hoffmannjoern/bottlemail_pcb/README.md

bottlemail_pcb
==============

PCB layout and schematics for Bottl(e)mail
