hoffmannjoern/bottlemail_pcb/BOM_Merged.ods

Qty | Lieferant | Order Number | Parts
1 | Aliexpress | Such as rhyme new original CN3065 DFN8 lithium battery charge management / protection chip IC | U3
5 | DigiKey | MSS1P2U | D2, D3, D4, D5, D6
2 | Farnell | 1469750 | R20, R21
2 | Farnell | 1469773RL | R18, R19
1 | Farnell | 2395925 | IC1
2 tot | Lipoly.de | 0.5W Solar Panel 5,5V 55x70mm SeeedStudio POW112D2P o.Ä. | SOLAR
2 | Lipoly.de | 2.5 mm JST XH-Style Shrouded Male Connector: 2-Pin, Straight (4-Pack) Pololu 2717 | SOLAR, LIPO-BAT
2 | Reichelt | BL 1X10G SMD2,00 | XBEE_SOCKET
1 | Reichelt | 16,0000-HC49U-S | Q1
1 | Reichelt | ATMEGA 1284P-AU | ATMEGA1284P-AU
1 | Reichelt | FT 232 RL | UART1_IC2
1 | Reichelt | IRLML 6402 | T_LIPO_USB
1 | Reichelt | L-1812AS 22µ | UART1_L2
2 | Reichelt | LG L29K | LED2, UART1_TX_LED
2 | Reichelt | LS L29K | LED1, UART1_RX_LED
2 | Reichelt | NPO-G0603 22P | C1, C9
0.33 | Reichelt | SL 1X36G 2,54, geteilt mit J1 reicht für jeweils 3 Boards | I2C
0 |  | siehe I2C (Zeile oben drüber) | JP1
3 | Reichelt | SMD-0603 1,0K | R9, R14, R15
2 | Reichelt | SMD-0603 100K | R6, R8
14 | Reichelt | SMD-0603 10K | R1, R2, R3, R4, R5, R7, R10, R11, R12, R13, R16, R_RESET, R_WAKEUP, UART1_R6
3 | Reichelt | SMD-0603 2,2K | R17, UART1_R7, UART1_R10
4 | Reichelt | TASTER 3301 | RESET_SW, SW_BEE_RST, SW_CHARGE_INDICATORS, SW_WAKEUP
1 | Reichelt | WSL 6G | ISP1
4 | Reichelt | X5R-G0805 10/16 | C17, C18, C19, C20
13 | Reichelt | X7R-G0603 100N | C2, C3, C4, C6, C7, C8, C11, C12, C14, C15, C16, UART1_C2, UART1_C11
2 | Reichelt | X7R-G0603 10N | UART1_C1, UART1_C10
3 | Reichelt | X7R-G1210 1,0 | C5, C10, C13
3 | Reichelt | ZVN 3306 F | Q5, Q6, Q7
3 | Seed Studio | ACC39145O | GROOVE_A6_A7, GROOVE_D7_D8, GROOVE_I2C
1 | Seed Studio | BLE Bee - Based on HM-11 Module | U2
1 | Seed Studio | Bluetooth V4.0 HM-11 BLE Module
1 | Sparkfun | PRT-00127 | U1
1 | Sparkfun | PRT-11417 Part 1/4 | AD
1 | Sparkfun | PRT-11417 Part 1/4 | POWER
1 | Sparkfun | PRT-11417 Part 2/4 | IOH
1 | Sparkfun | PRT-11417 Part 3/4 | IOL
1 | Sparkfun | PRT-00587 | USB_CONNECTOR
2 tot | Sparkfun | PRT-00339 | LIPO_BAT
