hoffmannjoern/bottlemail_pcb/Bottle_PCB_Components.pdf

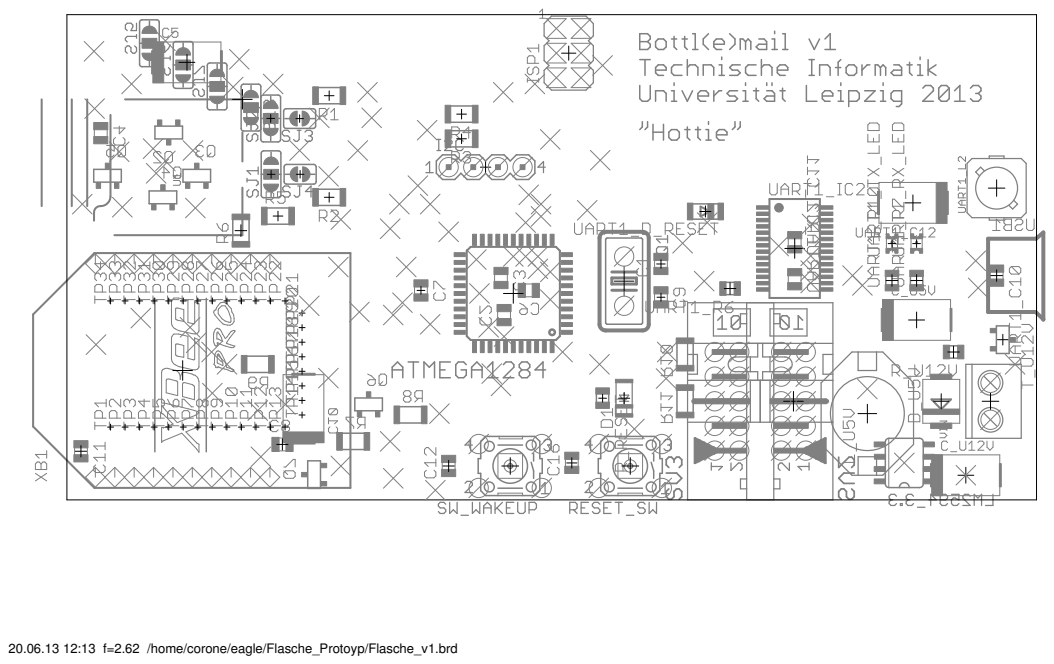
[picture p1: page 1]

20.06.13 12:13 f=2.62 /home/corone/eagle/Flasche_Protoyp/Flasche_v1.brd
