hoffmannjoern/bottlemail_pcb/Bottle_PCB_Board.pdf

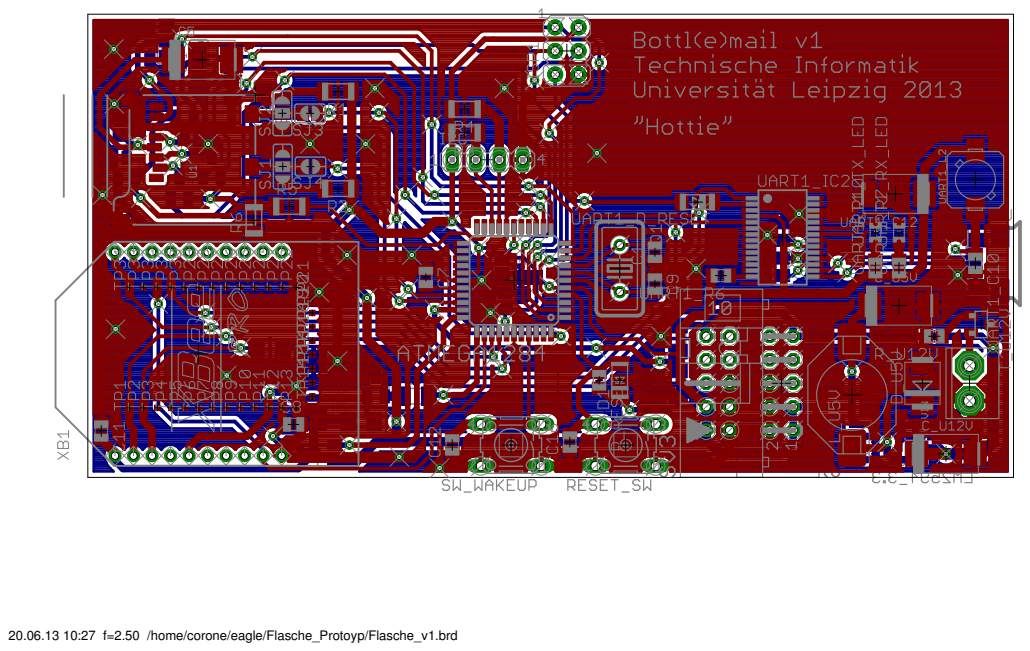
[picture p2: page 1]

20.06.13 10:27 f=2.50 /home/corone/eagle/Flasche_Protoyp/Flasche_v1.brd
