hoffmannjoern/bottlemail_pcb/Bottle_PCB_Board_Top.pdf

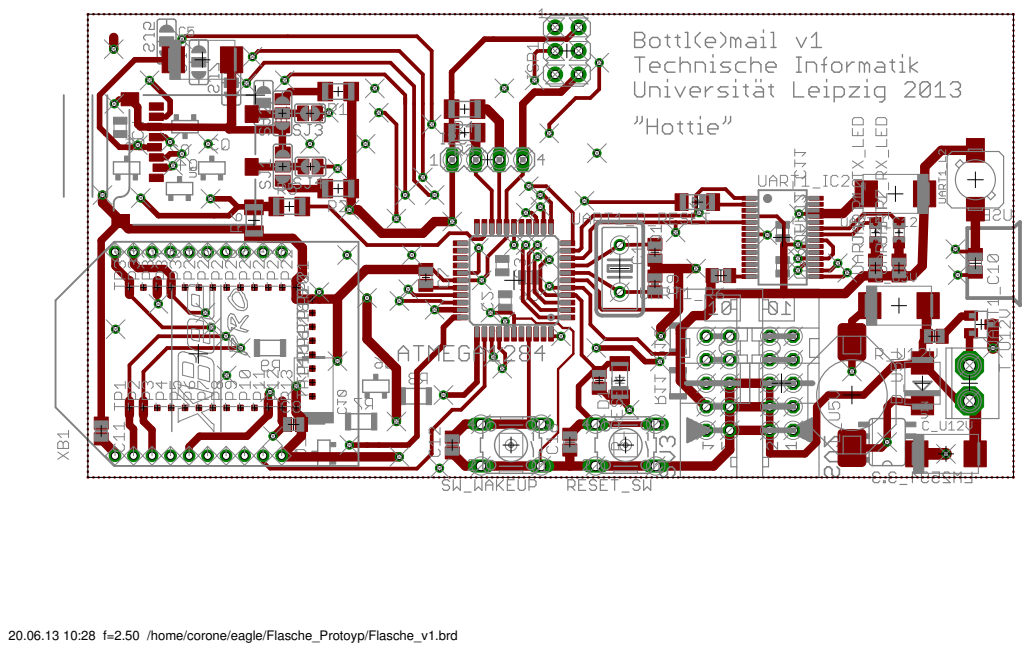
[picture p3: page 1]

20.06.13 10:28 f=2.50 /home/corone/eagle/Flasche_Protoyp/Flasche_v1.brd
