hoffmannjoern/bottlemail_pcb/Bottle_PCB_Layout.pdf

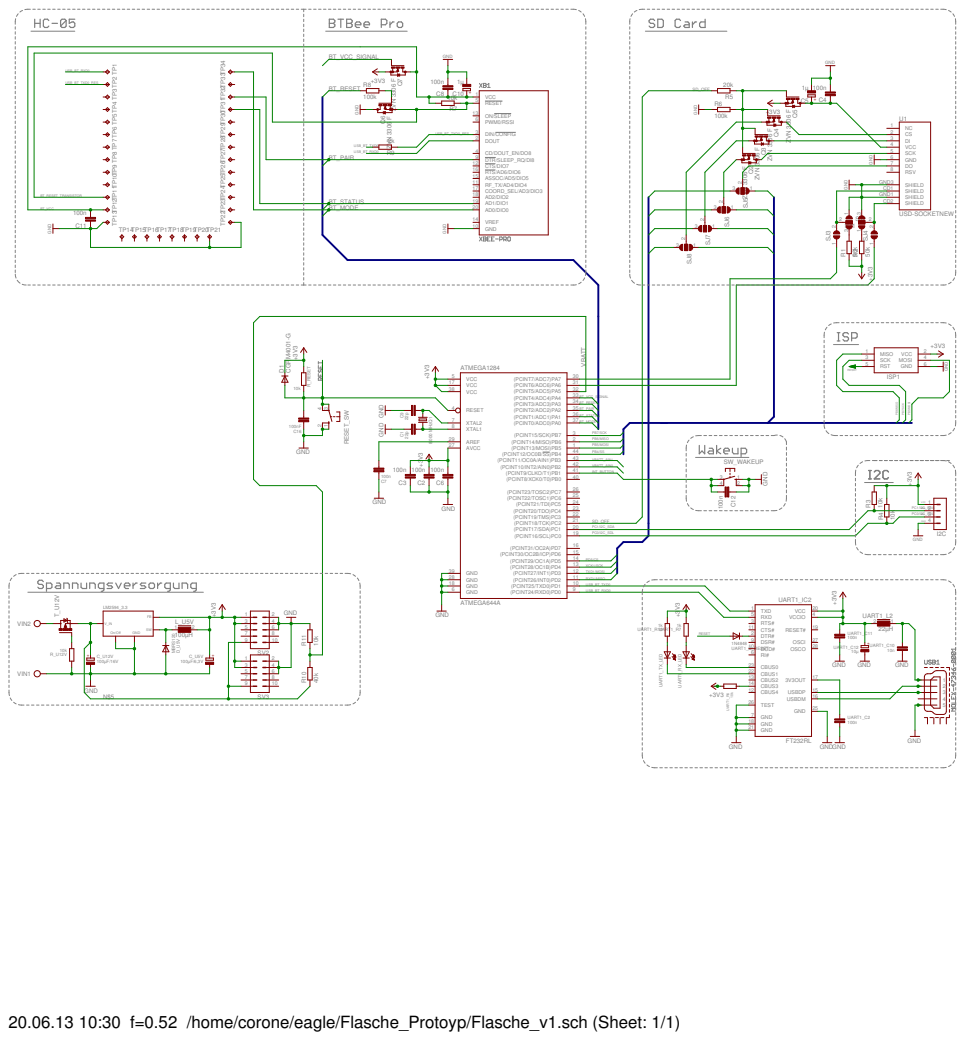
[picture p4: page 1]

BT_VCC_SIGNAL

20.06.13 10:30 f=0.52 /home/corone/eagle/Flasche_Protoyp/Flasche_v1.sch (Sheet: 1/1)
