hoffmannjoern/bottlemail_pcb/Bottle_PCB.brd

## EAGLE design Bottle_PCB.brd (2014-10-03)

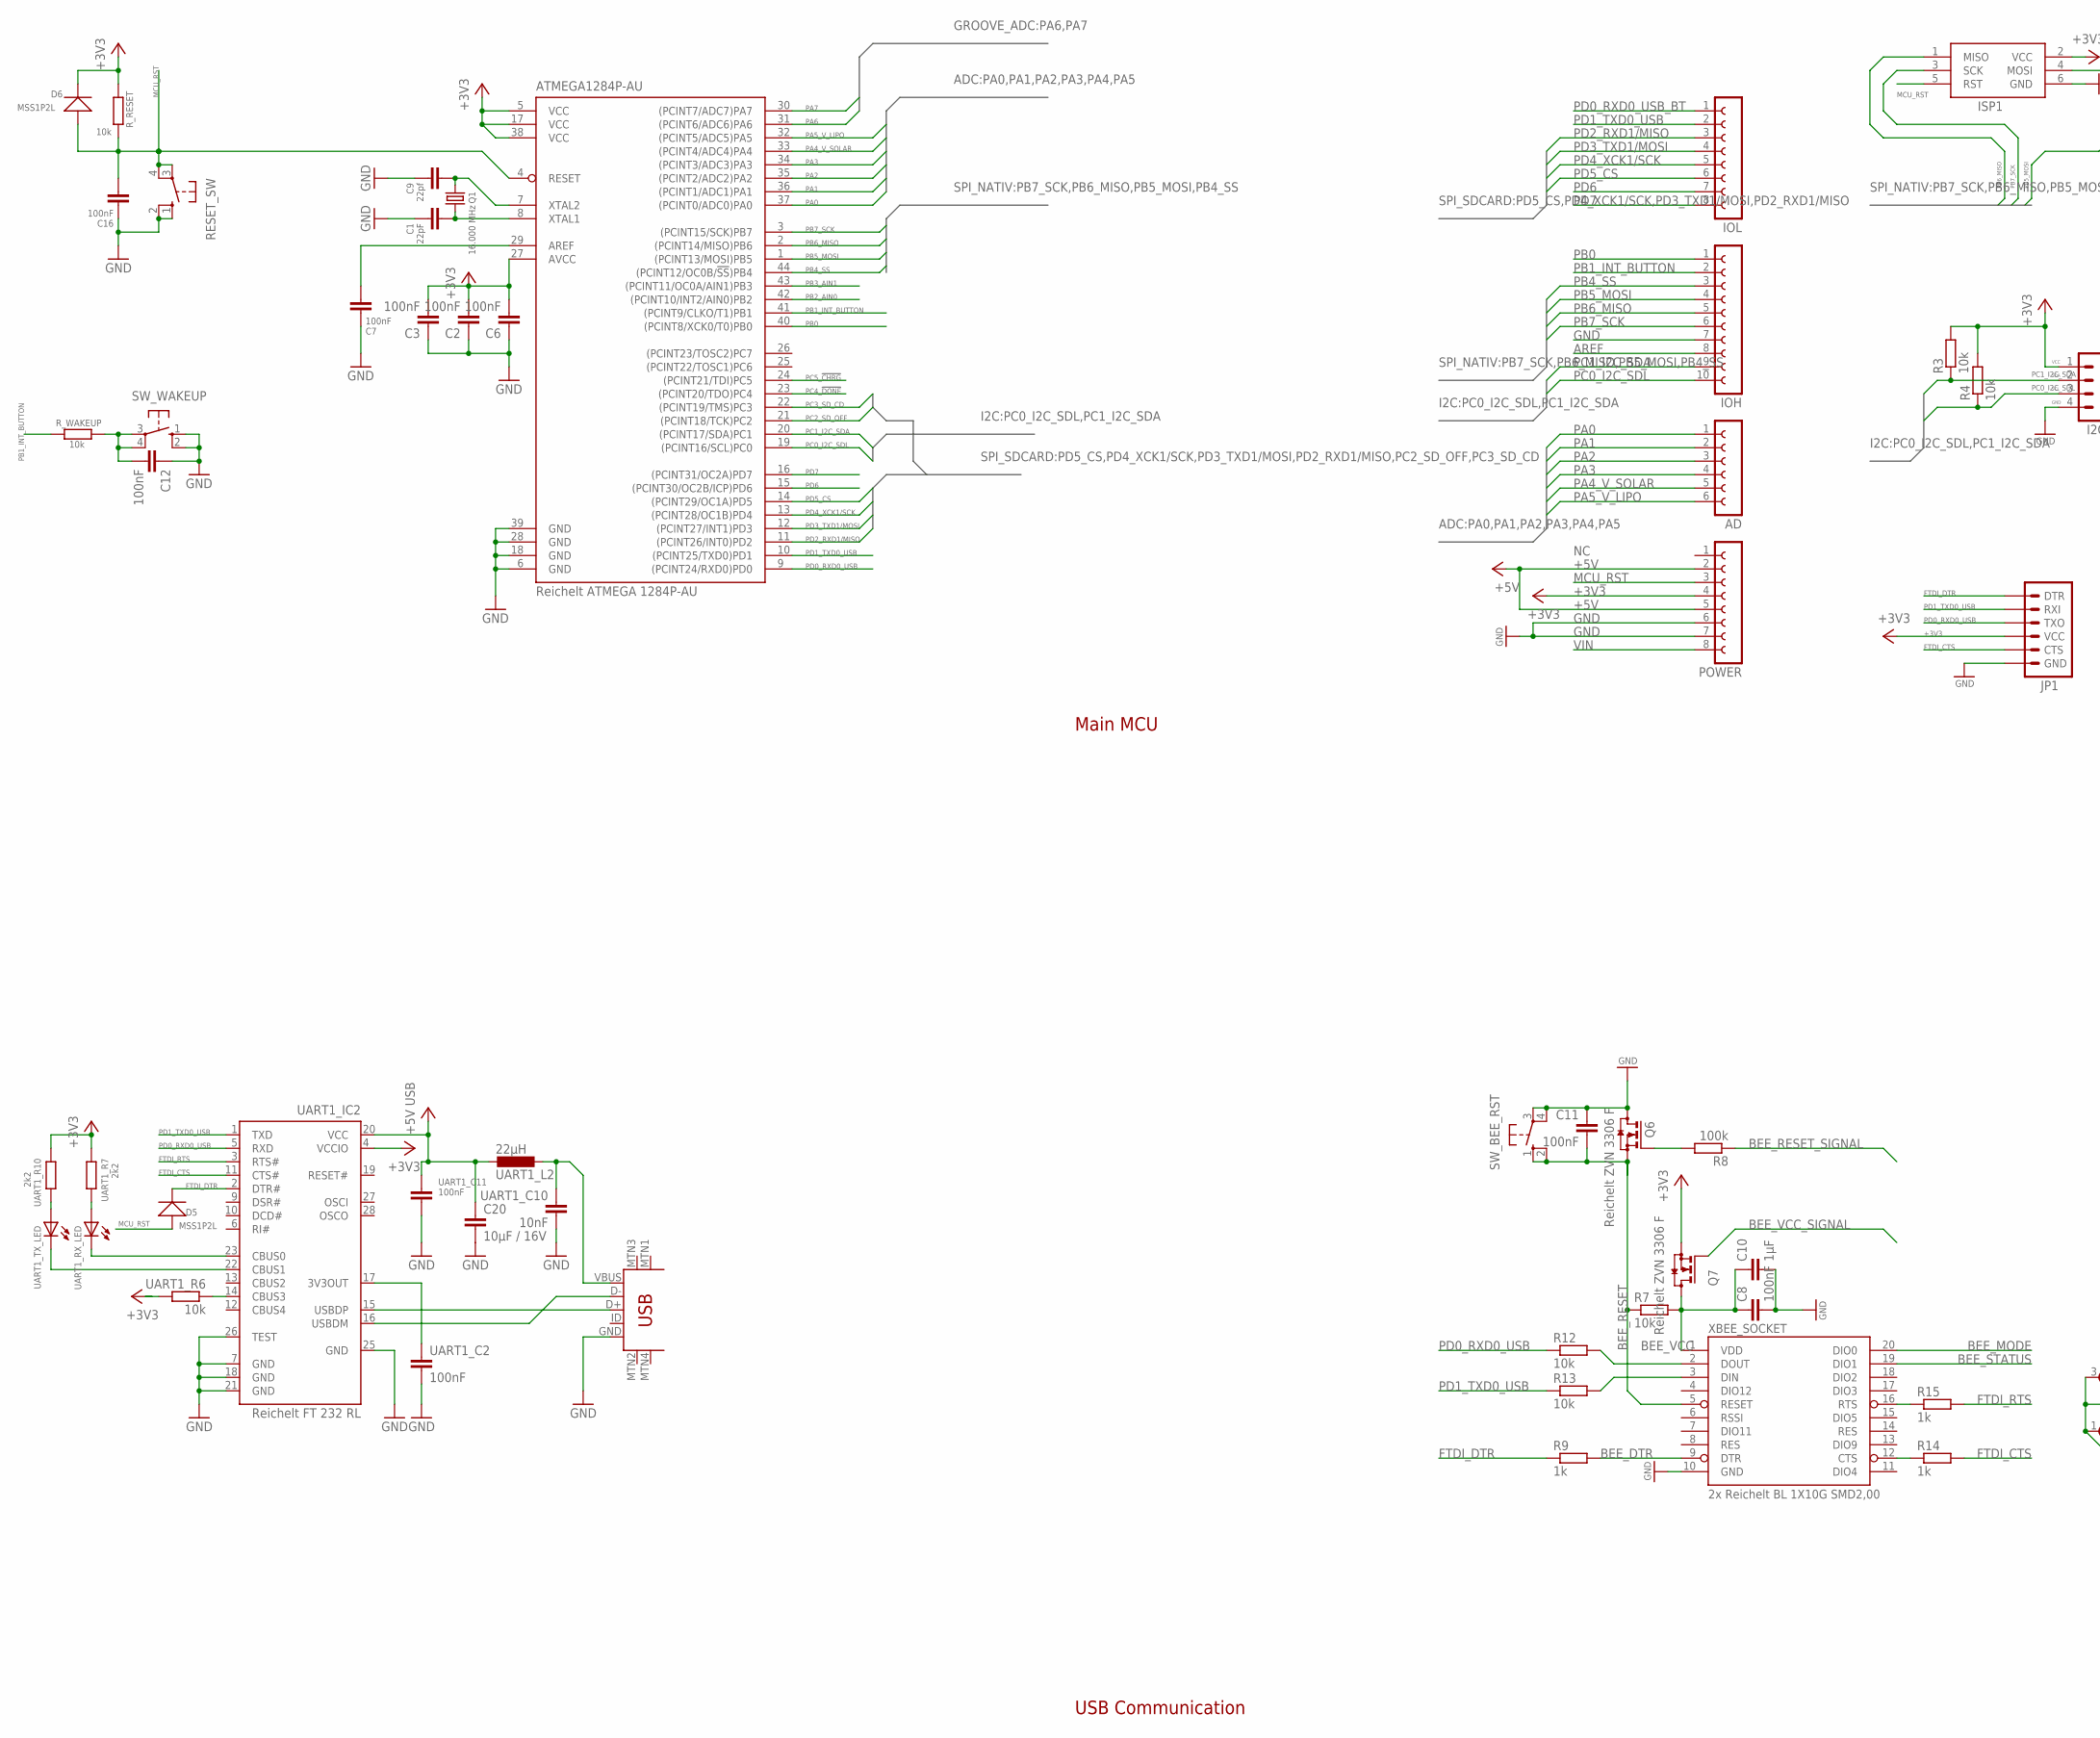
[picture p5: schematic Bottle_PCB.sch, Everything in order to support Eagle free Edition, part in row 1, column 1]

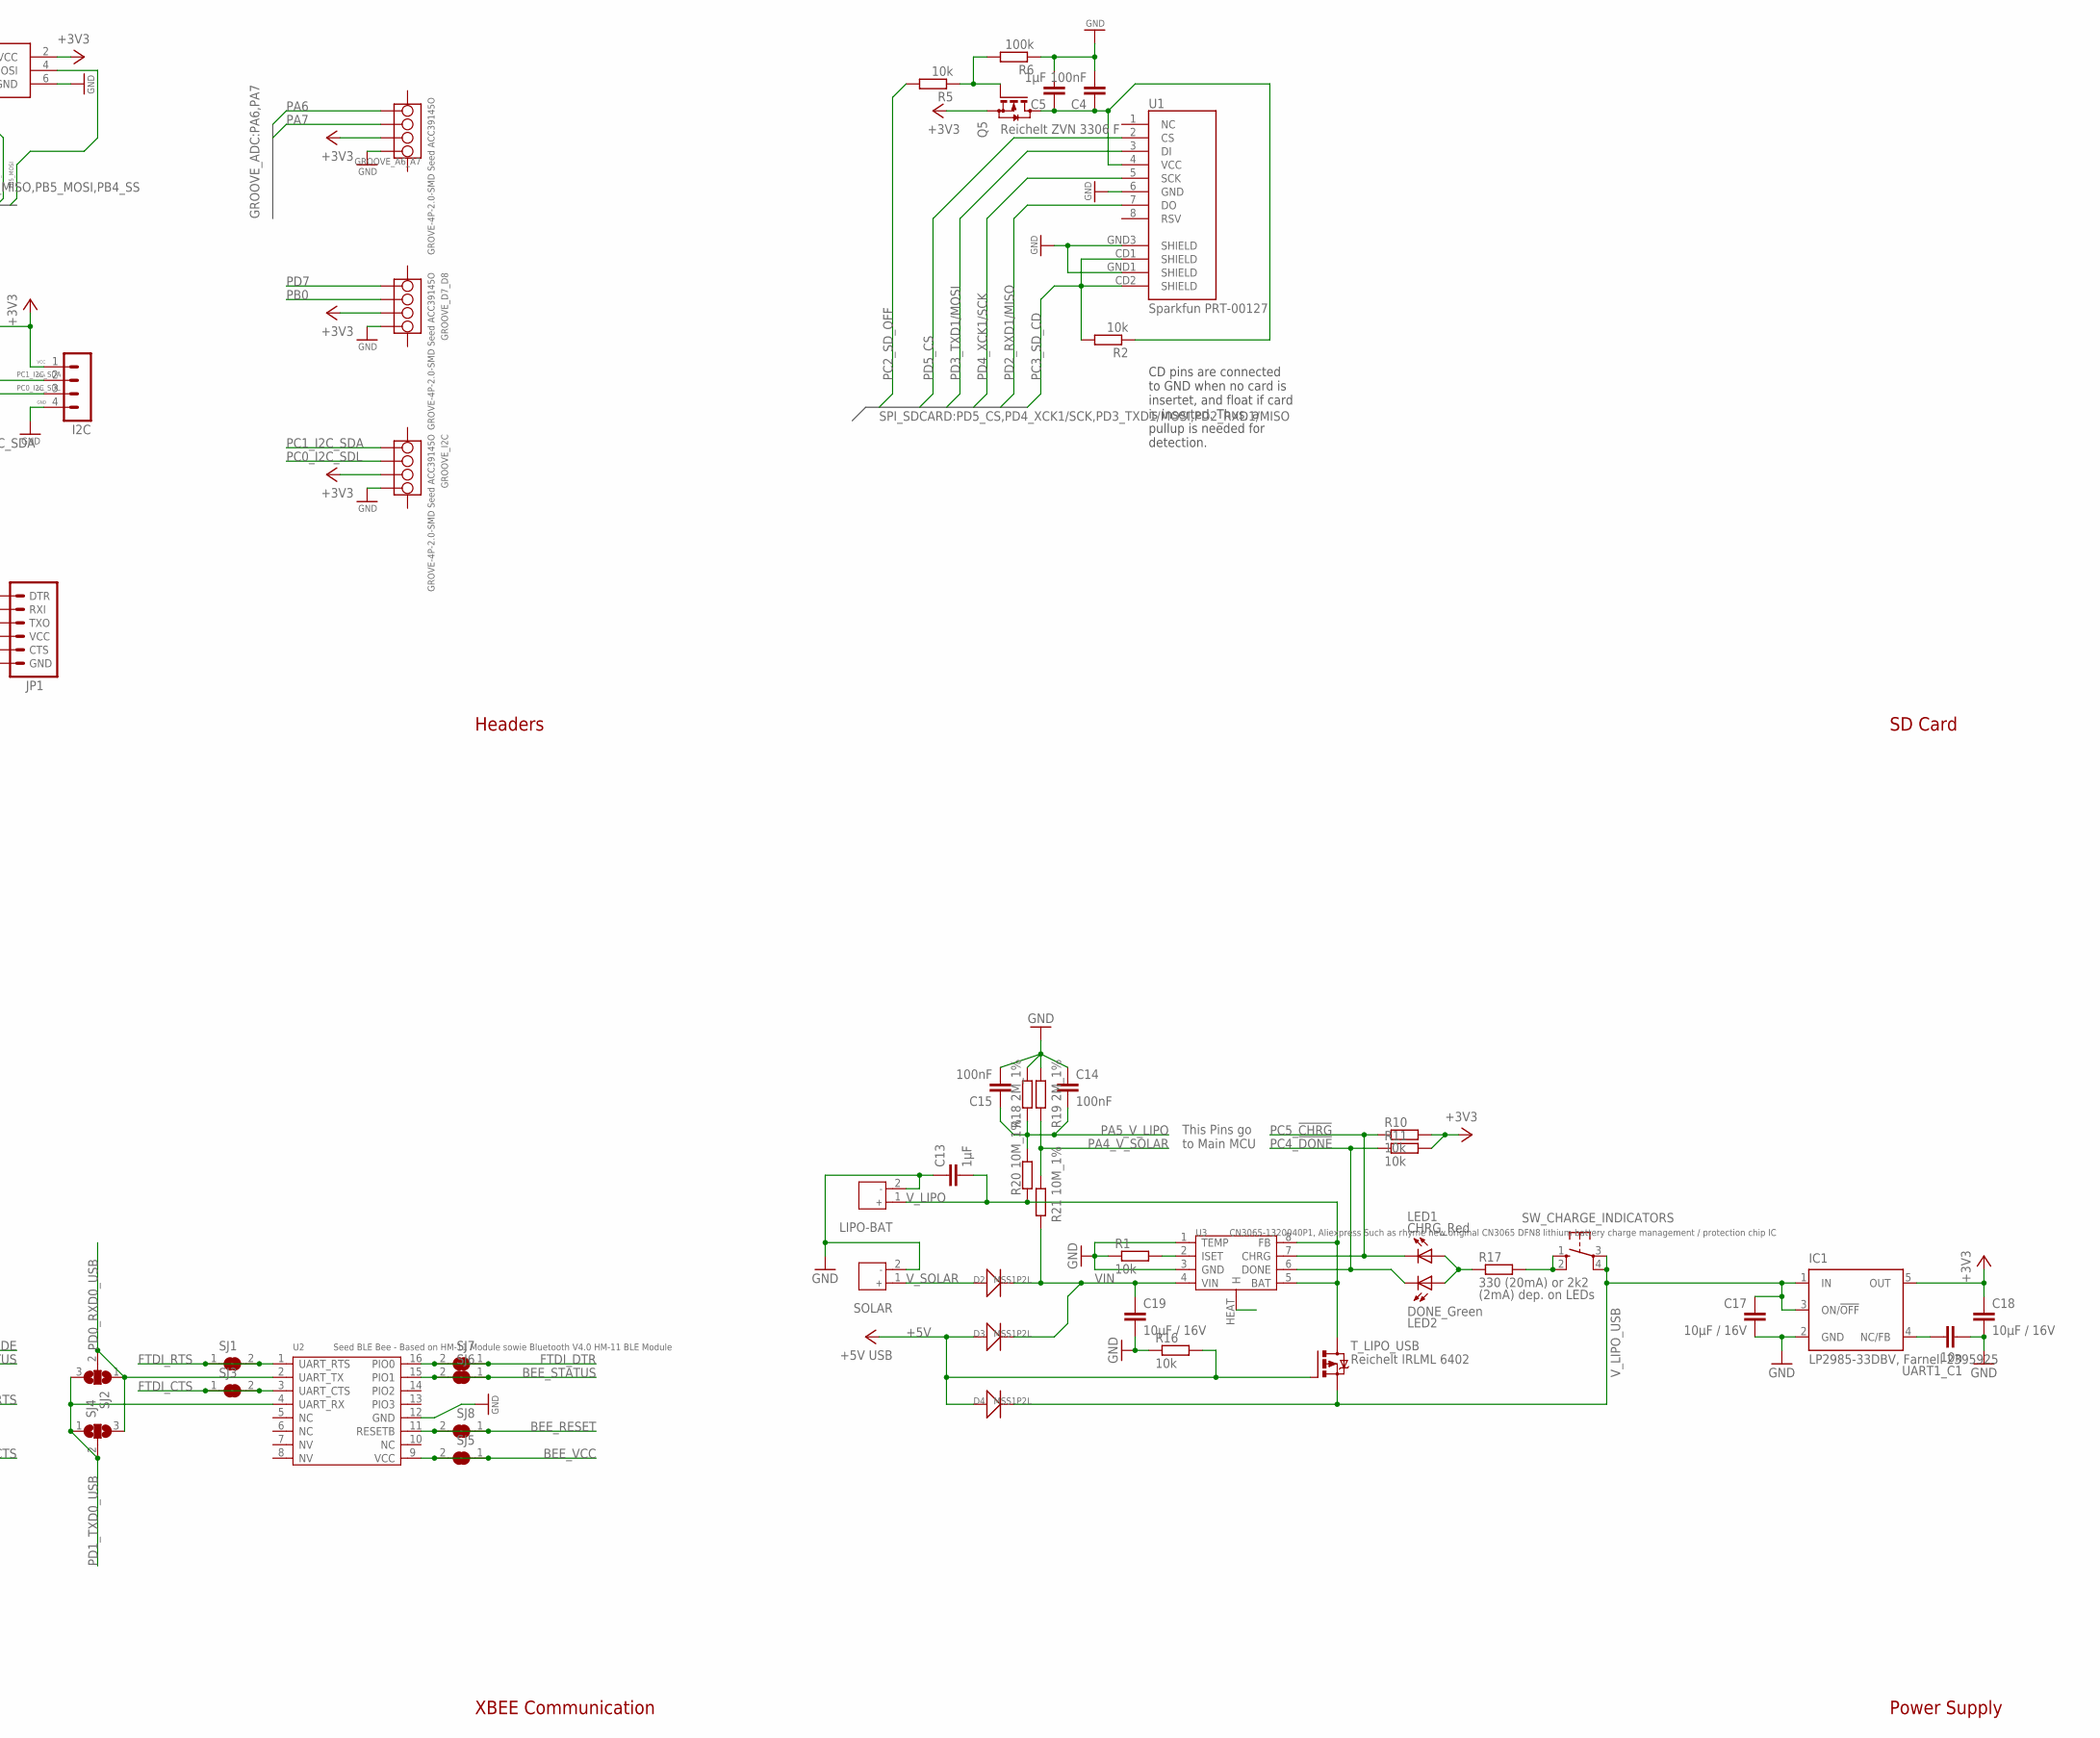
[picture p6: schematic Bottle_PCB.sch, Everything in order to support Eagle free Edition, part in row 1, column 2]

Parts:
AD: FE06-1; FE06
ATMEGA1284P-AU: Reichelt ATMEGA 1284P-AU; TQFP44
C1: 22pF; C0603-ROUND
C2, C3, C4, C6, C7, C8, C11, C12, C14, C15, C16: 100nF; C0603-ROUND
C5, C10, C13: 1µF; C1210
C9: 22pf; C0603-ROUND
C17, C18, C19, C20: 10µF / 16V; C0805
D2, D3, D4, D5, D6: MSS1P2L; D1005
GROOVE_A6_A7: GROVE-4P-2.0-SMD Seed ACC39145O; 4P-SMD-2.0
GROOVE_D7_D8: GROVE-4P-2.0-SMD Seed ACC39145O; 4P-SMD-2.0
GROOVE_I2C: GROVE-4P-2.0-SMD Seed ACC39145O; 4P-SMD-2.0
I2C: MA04-1
IC1: LP2985-33DBV, Farnell 2395925; SOT23-DBV
IOH: FE10-1; FE10
IOL: FE08-1; FE08
ISP1: Reichelt WSL 6G; AVRISP
JP1: ARDUINO_SERIAL_PROGRAMPTH; 1X06
LED1: CHRG_Red; CHIPLED_0603
LED2: DONE_Green; CHIPLED_0603
LIPO-BAT: JACK-JST-2P-PW2.0; JST-2.0
POWER: FE08-1; FE08
Q1: 16.000 MHz; HC49U-V
Q5, Q6, Q7: Reichelt ZVN 3306 F; SOT23
R1, R2, R3, R4, R5, R7, R10, R11, R12, R13, R16: 10k; R0603-ROUND
R6, R8: 100k; R0603-ROUND
R9, R14, R15: 1k; R0603-ROUND
R17: 330 (20mA) or 2k2; R0603-ROUND
R18, R19: 2M_1%; R0603-ROUND
R20, R21: 10M_1%; R0603-ROUND
RESET_SW: 10-XX; B3F-10XX
R_RESET: 10k; R0603-ROUND
R_WAKEUP: 10k; R0603-ROUND
SJ1, SJ3, SJ5, SJ6, SJ7, SJ8: SJ
SJ2, SJ4: SJ2W; SJ_2
SOLAR: JACK-JST-2P-PW2.0; JST-2.0
SW_BEE_RST: 10-XX; B3F-10XX
SW_CHARGE_INDICATORS: 10-XX; B3F-10XX
SW_WAKEUP: 10-XX; B3F-10XX
T_LIPO_USB: Reichelt IRLML 6402; SOT23
U1: Sparkfun PRT-00127; MICRO-SD-SOCKET-PP
U2: Seed BLE Bee - Based on HM-11 Module sowie Blueto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; 16P-18.5X13.5X0.8
U3: CN3065-1320040P1, Aliexpress Such as rhyme new or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; DFN8
UART1_C1: 10n; C0603-ROUND
UART1_C2, UART1_C11: 100nF; C0603-ROUND
UART1_C10: 10nF; C0603-ROUND
UART1_IC2: Reichelt FT 232 RL; SSOP28
UART1_L2: 22µH; L1812
UART1_R6: 10k; R0603-ROUND
UART1_R7, UART1_R10: 2k2; R0603-ROUND
UART1_RX_LED, UART1_TX_LED: LEDCHIPLED_0603; CHIPLED_0603
USB_CONNECTOR: USB-MINIB-5PIN Sparkfun PRT-00587; USB-MINIB
XBEE_SOCKET: 2x Reichelt BL 1X10G SMD2,00; XBEE-SMD

Connections:
+3V3: ATMEGA1284P-AU.5 (VCC), ATMEGA1284P-AU.17 (VCC), ATMEGA1284P-AU.27 (AVCC), ATMEGA1284P-AU.38 (VCC), C2.2, C3.2, C6.2, C18.1, D6.-, GROOVE_A6_A7.2, GROOVE_D7_D8.2, GROOVE_I2C.2, I2C.1, IC1.5 (OUT), ISP1.2 (VCC), JP1.VCC, POWER.4, Q5.2 (S), Q7.2 (S), R3.2, R4.2, R10.2, R11.2, R_RESET.2, UART1_IC2.4 (VCCIO), UART1_R6.2, UART1_R7.1, UART1_R10.1
+5V: C20.1, D3.+, D4.+, POWER.2, POWER.5, R16.2, T_LIPO_USB.1 (G), UART1_C11.1, UART1_IC2.20 (VCC), UART1_L2.2
AREF: ATMEGA1284P-AU.29 (AREF), C7.2, IOH.8
BEE_DTR: R9.2, XBEE_SOCKET.9 (DTR)
BEE_MODE: XBEE_SOCKET.20 (DIO0)
BEE_RESET: C11.2, Q6.2 (S), R7.1, SJ8.1, SJ8.2, SW_BEE_RST.1 (S), SW_BEE_RST.2 (S1), U2.11 (RESETB), XBEE_SOCKET.5 (RESET)
BEE_RESET_SIGNAL: R8.1
BEE_STATUS: SJ6.1, SJ6.2, U2.15 (PIO1), XBEE_SOCKET.19 (DIO1)
BEE_VCC: C8.1, C10.1, Q7.3 (D), R7.2, SJ5.1, SJ5.2, U2.9 (VCC), XBEE_SOCKET.1 (VDD)
BEE_VCC_SIGNAL: Q7.1 (G)
FTDI_CTS: JP1.CTS, R14.2, SJ3.1, SJ3.2, U2.3 (UART_CTS), UART1_IC2.11 (CTS#)
FTDI_DTR: D5.-, JP1.DTR, R9.1, SJ7.1, SJ7.2, U2.16 (PIO0), UART1_IC2.2 (DTR#)
FTDI_RTS: R15.2, SJ1.1, SJ1.2, U2.1 (UART_RTS), UART1_IC2.3 (RTS#)
GND: ATMEGA1284P-AU.6 (GND), ATMEGA1284P-AU.18 (GND), ATMEGA1284P-AU.28 (GND), ATMEGA1284P-AU.39 (GND), C1.1, C2.1, C3.1, C4.2, C5.2, C6.1, C7.1, C8.2, C9.1, C10.2, C11.1, C12.1, C13.1, C14.1, C15.2, C16.1, C17.2, C18.2, C19.2, C20.2, GROOVE_A6_A7.1, GROOVE_D7_D8.1, GROOVE_I2C.1, I2C.4, IC1.2 (GND), IOH.7, ISP1.6 (GND), JP1.GND, LIPO-BAT.2, POWER.6, POWER.7, Q6.3 (D), R1.1, R6.1, R16.1, R18.2, R19.2, RESET_SW.1 (S), RESET_SW.2 (S1), SOLAR.2, SW_BEE_RST.3, SW_BEE_RST.4 (P1), SW_WAKEUP.1 (S), SW_WAKEUP.2 (S1), U1.6 (GND), U1.GND1 (SHIELD), U1.GND3 (SHIELD), U2.12 (GND), U3.1 (TEMP), U3.3 (GND), UART1_C1.2, UART1_C2.2, UART1_C10.2, UART1_C11.2, UART1_IC2.7 (GND), UART1_IC2.18 (GND), UART1_IC2.21 (GND), UART1_IC2.25 (GND), UART1_IC2.26 (TEST), USB_CONNECTOR.GND, XBEE_SOCKET.10 (GND)
MCU_RST: ATMEGA1284P-AU.4 (RESET), C16.2, D5.+, D6.+, ISP1.5 (RST), POWER.3, RESET_SW.3, RESET_SW.4 (P1), R_RESET.1
unnamed: UART1_R10.2, UART1_TX_LED.A
unnamed: UART1_C2.1, UART1_IC2.17 (3V3OUT)
unnamed: IC1.4 (NC/FB), UART1_C1.1
unnamed: UART1_IC2.16 (USBDM), USB_CONNECTOR.D-
unnamed: R14.1, XBEE_SOCKET.12 (CTS)
unnamed: R15.1, XBEE_SOCKET.16 (RTS)
unnamed: R12.2, XBEE_SOCKET.2 (DOUT)
unnamed: UART1_R7.2, UART1_RX_LED.A
unnamed: UART1_IC2.15 (USBDP), USB_CONNECTOR.D+
unnamed: UART1_IC2.14 (CBUS3), UART1_R6.1
unnamed: UART1_C10.1, UART1_L2.1, USB_CONNECTOR.VBUS
unnamed: UART1_IC2.23 (CBUS0), UART1_RX_LED.C
unnamed: UART1_IC2.22 (CBUS1), UART1_TX_LED.C
unnamed: R13.2, XBEE_SOCKET.3 (DIN)
unnamed: C12.2, R_WAKEUP.1, SW_WAKEUP.3, SW_WAKEUP.4 (P1)
unnamed: LED1.A, LED2.A, R17.1
unnamed: R17.2, SW_CHARGE_INDICATORS.1 (S), SW_CHARGE_INDICATORS.2 (S1)
unnamed: R1.2, U3.2 (ISET)
unnamed: C4.1, C5.1, Q5.3 (D), R2.1, U1.4 (VCC)
unnamed: Q5.1 (G), R5.1, R6.2
unnamed: Q6.1 (G), R8.2
PA0: AD.1, ATMEGA1284P-AU.37 ((PCINT0/ADC0)PA0)
PA1: AD.2, ATMEGA1284P-AU.36 ((PCINT1/ADC1)PA1)
PA2: AD.3, ATMEGA1284P-AU.35 ((PCINT2/ADC2)PA2)
PA3: AD.4, ATMEGA1284P-AU.34 ((PCINT3/ADC3)PA3)
PA4_V_SOLAR: AD.5, ATMEGA1284P-AU.33 ((PCINT4/ADC4)PA4), R19.1, R21.2
PA5_V_LIPO: AD.6, ATMEGA1284P-AU.32 ((PCINT5/ADC5)PA5), C14.2, C15.1, R18.1, R20.2
PA6: ATMEGA1284P-AU.31 ((PCINT6/ADC6)PA6), GROOVE_A6_A7.4
PA7: ATMEGA1284P-AU.30 ((PCINT7/ADC7)PA7), GROOVE_A6_A7.3
PB0: ATMEGA1284P-AU.40 ((PCINT8/XCK0/T0)PB0), GROOVE_D7_D8.3, IOH.1
PB1_INT_BUTTON: ATMEGA1284P-AU.41 ((PCINT9/CLKO/T1)PB1), IOH.2
PB2_AIN0: ATMEGA1284P-AU.42 ((PCINT10/INT2/AIN0)PB2)
PB3_AIN1: ATMEGA1284P-AU.43 ((PCINT11/OC0A/AIN1)PB3)
PB4_SS: ATMEGA1284P-AU.44 ((PCINT12/OC0B/!SS!)PB4), IOH.3
PB5_MOSI: ATMEGA1284P-AU.1 ((PCINT13/MOSI)PB5), IOH.4, ISP1.4 (MOSI)
PB6_MISO: ATMEGA1284P-AU.2 ((PCINT14/MISO)PB6), IOH.5, ISP1.1 (MISO)
PB7_SCK: ATMEGA1284P-AU.3 ((PCINT15/SCK)PB7), IOH.6, ISP1.3 (SCK)
PC0_I2C_SDL: ATMEGA1284P-AU.19 ((PCINT16/SCL)PC0), GROOVE_I2C.3, I2C.3, IOH.10, R4.1
PC1_I2C_SDA: ATMEGA1284P-AU.20 ((PCINT17/SDA)PC1), GROOVE_I2C.4, I2C.2, IOH.9, R3.1
PC2_SD_OFF: ATMEGA1284P-AU.21 ((PCINT18/TCK)PC2), R5.2
PC3_SD_CD: ATMEGA1284P-AU.22 ((PCINT19/TMS)PC3), R2.2, U1.CD1 (SHIELD), U1.CD2 (SHIELD)
PC4_!DONE: ATMEGA1284P-AU.23 ((PCINT20/TDO)PC4), LED2.C, R11.1, U3.6 (DONE)
PC5_!CHRG: ATMEGA1284P-AU.24 ((PCINT21/TDI)PC5), LED1.C, R10.1, U3.7 (CHRG)
PD0_RXD0_USB: ATMEGA1284P-AU.9 ((PCINT24/RXD0)PD0), JP1.TXO, R12.1, SJ2.1, SJ2.2, SJ4.3, U2.2 (UART_TX), UART1_IC2.5 (RXD)
PD0_RXD0_USB_BT: IOL.1
PD1_TXD0_USB: ATMEGA1284P-AU.10 ((PCINT25/TXD0)PD1), IOL.2, JP1.RXI, R13.1, SJ2.3, SJ4.1, SJ4.2, U2.4 (UART_RX), UART1_IC2.1 (TXD)
PD2_RXD1/MISO: ATMEGA1284P-AU.11 ((PCINT26/INT0)PD2), IOL.3, U1.7 (DO)
PD3_TXD1/MOSI: ATMEGA1284P-AU.12 ((PCINT27/INT1)PD3), IOL.4, U1.3 (DI)
PD4_XCK1/SCK: ATMEGA1284P-AU.13 ((PCINT28/OC1B)PD4), IOL.5, U1.5 (SCK)
PD5_CS: ATMEGA1284P-AU.14 ((PCINT29/OC1A)PD5), IOL.6, U1.2 (CS)
PD6: ATMEGA1284P-AU.15 ((PCINT30/OC2B/ICP)PD6), IOL.7
PD7: ATMEGA1284P-AU.16 ((PCINT31/OC2A)PD7), GROOVE_D7_D8.4, IOL.8
VIN: C19.1, D2.-, D3.-, POWER.8, R21.1, U3.4 (VIN)
V_LIPO: C13.2, LIPO-BAT.1, R20.1, T_LIPO_USB.2 (D), U3.5 (BAT), U3.8 (FB)
V_LIPO_USB: C17.1, D4.-, IC1.1 (IN), IC1.3 (ON/!OFF), SW_CHARGE_INDICATORS.3, SW_CHARGE_INDICATORS.4 (P1), T_LIPO_USB.3 (S)
V_SOLAR: D2.+, SOLAR.1
XTAL1: ATMEGA1284P-AU.8 (XTAL1), C1.2, Q1.1
XTAL2: ATMEGA1284P-AU.7 (XTAL2), C9.2, Q1.2

Notes on the sheet:
VCC
SDA
SCL
GND
Main MCU
Headers
XBEE Communication
USB Communication
SD Card
Power Supply
CD pins are connected to GND when no card is insertet, and float if card is inserted. Thus, a pullup is needed for detection.
(2mA) dep. on LEDs
This Pins go to Main MCU

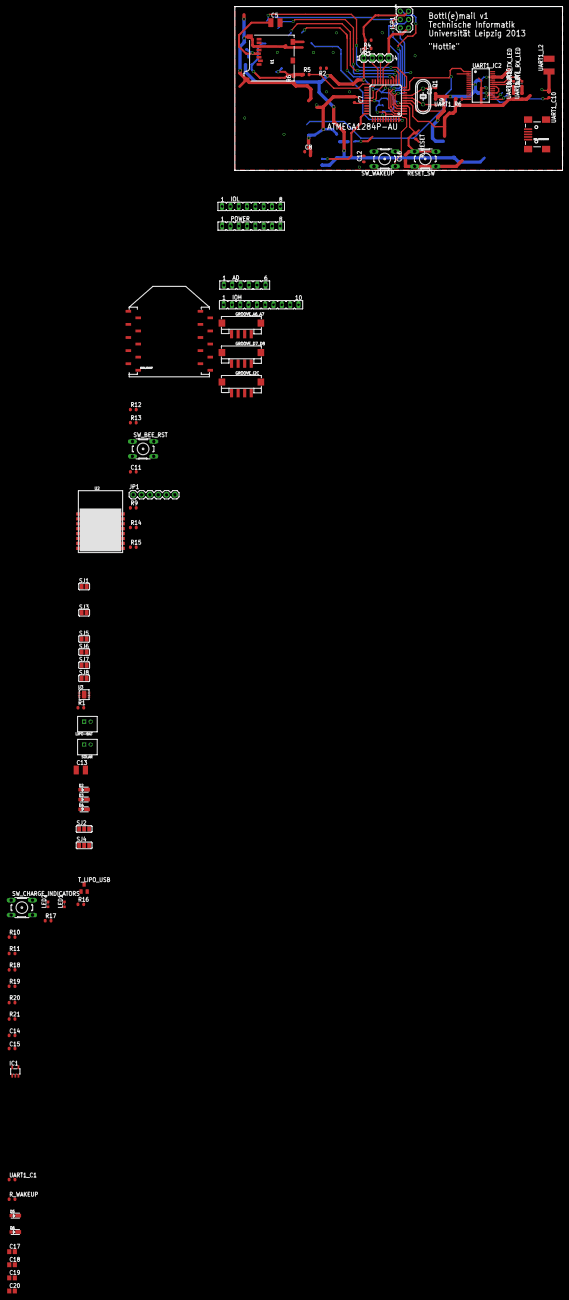
[picture p7: board Bottle_PCB.brd from above]

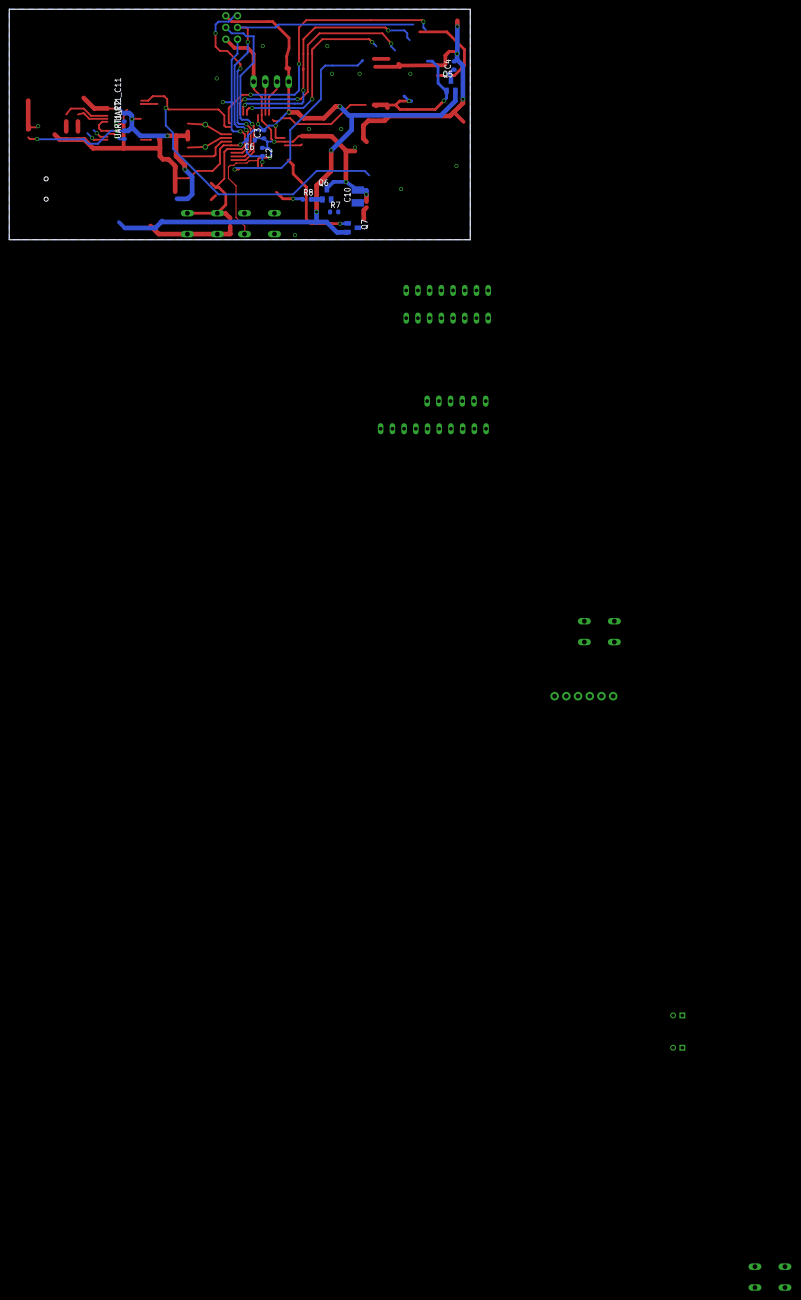
[picture p8: board Bottle_PCB.brd from below]

Board: 2 copper layers, 100.0 x 50.0 mm, 97 parts (12 on the bottom side), 67 nets.
