hoffmannjoern/bottlemail_pcb/(commit log)

2014-09-10 Initial commit, latest PCB version from end of project in 2013
    [Bottle_PCB.brd, Bottle_PCB.sch]
2014-09-10 - Added Arduino Shield headers - cleaned up the schmeatic and grouped modules on sheets by function - inserted and de-crossed bus systems - started to unify font sizes and pin / netwrok naming
    [Bottle_PCB.brd, Bottle_PCB.sch]
2014-09-28 - employes Seeduino Open Parts Library for groove connectors and possibly more in the future - added groove connectors
    [Bottle_PCB.brd, Bottle_PCB.sch]
2014-09-28 - changed old BTBee Pro specific socketing into more generic XBEE socket
    [Bottle_PCB.brd, Bottle_PCB.sch]
2014-09-28 - added FTDI serial connector - employed sparkfun lib for connectors
    [Bottle_PCB.brd, Bottle_PCB.sch]
2014-09-28 - connected FTDI and XBEE Socket
    [Bottle_PCB.brd, Bottle_PCB.sch]
2014-09-28 - added some more frames for structure
    [Bottle_PCB.sch]
2014-09-28 - overhauled and simplified SD card connection - decided to stick with the sparkfun socket, as it's cheap and available by now
    [Bottle_PCB.brd, Bottle_PCB.sch]
2014-09-29 - added HM11 BT Module - employed component device exported from SeedStudio BLE_Bee_v1.0 schematic
    [Bottle_PCB.brd, Bottle_PCB.sch]
2014-09-29 - employed several more libraries from Seed Studio and Arduino Project - replaced power supply with modern solution, charging circuitry etc.
    [Bottle_PCB.brd, Bottle_PCB.sch]
2014-09-29 - replaces mini USB B connector with SparkFun version
    [Bottle_PCB.brd, Bottle_PCB.sch]
2014-09-29 - cleaned up and unified many discrete components - set Reichelt Order Numbers for all capacitors
    [Bottle_PCB.brd, Bottle_PCB.sch]
2014-10-01 - unified, replaced and checked all components - added vendor IDs and order information to all components - generated BOMs
    [BOM_Main.csv, BOM_OrderNumbers.csv, Bottle_PCB.brd, Bottle_PCB.sch]
2014-10-01 - merged BOMs - BOM_Merged.csv is checked for correctness and completeness - minor adjustments in Device Values for unification
    [BOM_Main.csv, BOM_Merged.ods, Bottle_PCB.brd, Bottle_PCB.sch]
2014-10-03 - replaced Diodes with lower quality version, as they are easier to get - added important BOM information
    [BOM_Merged.ods, Bottle_PCB.brd, Bottle_PCB.sch]
